AgitPOV/Coyote/circuit/coyote 1/stencil/AgitPOV_coyote_stencil.png

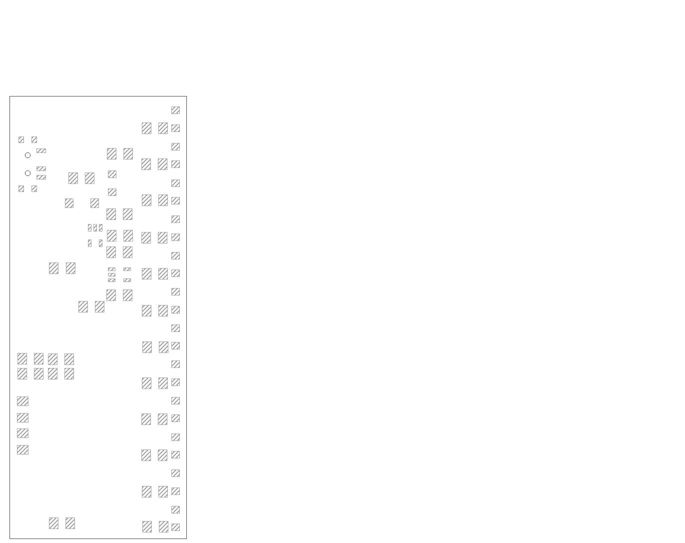
circuit/coyote 1/stencil/AgitPOV_coyote_stencil.png
