AgitPOV/Coyote/circuit/coyote 1/BOM/Coyote Partslist.ods

Item # | Qty | Numéro | Valor | Codigo | QTY | Prix Digikey Canada | http://www.sigmaelectronica.net | http://www.didacticaselectronicas.com | http://www.microelectronicos.com | Prix par POV / Digikey | Notas
 | 1 | C1 | 470 pF | 311-1167-1-ND | 100 | 0.0531 | - | - | - | 0.0531
 | 3 | C2,C3, C4 | .1 uF | 311-1179-1-ND | 100 | 0.0434 | 0.029 | 0.025 | 0.025 | 0.1302 | 100 nF = 0.1uF
 | 3 | C6, C7. C8 | 4.7 uF | 1276-1191-1-ND | 100 | 0.0793 |  | 0.025 | - | 0.2379
 | 2 | C5, C9 | 18 pF | 311-1152-1-ND | 100 | 0.0632 | - | 0.025 | - | 0.1264 | Selon le datasheet
 | 1 | Hall Sensor |  | 620-1330-ND | 100 | 1.0393 | - | - | - | 1.0393
 | 1 | MCP 73831 |  | MCP73831T-2ACI/OTCT-ND | 100 | 0.501 |  |  |  | 0.501
 | 1 | D1 | B340A | B340A-FDICT-ND | 100 | 0.3322 | - | 0.82 | - | 0.3322
 | 1 | MIC 5219 |  | 576-1281-1-ND | 100 | 1.6827 |  |  |  | 1.6827
 | 1 | Switch SPDT |  | 563-1102-1-ND | 100 | 0.6826 |  | 1.33 |  | 0.6826
 | 1 | Atmega |  | ATMEGA168A-PU-ND | 100 | 2.6232 | 3.86 | - | - | 2.6232
 | 1 | Piles LiPO | 3,7 V 450 ma |  | 100 | 3 |  |  |  | 3
 |  | JP2 |  |  |  |  |  |  |  | 0
 | 1 | LED 1 |  | vert normcore |  |  |  |  |  | 0
 | 1 | Connecteur USB - USB MB h |  | WM17121-ND | 100 | 2.1121 | - | - | - | 2.1121
 | 1 | Push button switch |  | SW400-ND | 100 | 0.3843 | - | 0.051 | - | 0.3843
 | 1 | R1 | 330 | RMCF1206JT330RCT-ND | 100 | 0.0178 |  |  |  | 0.0178
 | 2 | R2, R4 | 10k | RMCF1206JT10K0CT-ND | 100 | 0.0178 | 0.0123 |  |  | 0.0356
 | 12 | R 3, 5-15 | 51 | 311-51ERCT-ND | 100 | 0.0132 |  |  |  | 0.1584 | bonjour coco!
 | 1 | R18 | 1.5 k | 311-1.50KFRCT-ND | 100 | 0.0168 |  |  |  | 0.0168 | <3
 | 2 | R16, R17 | 68 ohms | 311-51ERCT-ND | 100 | 0.0267 | 0.0123 |  |  | 0.0534 | hola gatito!
 | 1 | Y2 Crystal | 12 Mhz | CTX904-ND | 100 | 0.2863 | - | - | - | 0.2863
 |  | LED Rojo |  | 754-1143-1-ND / 754-1113-1-ND |  |  |  |  |  | 0
 | 12 | LED Naranja |  | 754-1140-1-ND | 100 | 0.1358 |  |  |  | 1.6296
 |  |  |  |  |  |  |  |  |  | 0
 | 1 | Female Headers | 4 | S7037-ND | 100 | 0.4348 |  | 0.6664 |  | 0.4348 | cher!!
 | 1 | Female Headers | 5 | S7038-ND | 100 | 0.4563 |  | 0.6664 |  | 0.4563 | tambien!
 | 1 | Plaquetas |  | Coyote 1 |  | 2.5 |  | (Ultimate PCB) |  | 2.5
 | 1 | Stencil |  |  |  | 2 |  | (Stentech) |  | 2
 |  |  |  |  |  |  |  |  |  | 20.494
 | 1 | Caja |  |  |  | 4 |  |  |  | 4 | Avec l'aide de Danny
 |  |  |  |  |  |  |  |  |  |  | bravo Danny¡¡ :)
 | 1 | Portamicros |  |  |  |  | 0.1189 |  | 0.205
(option) | 2 | C5, C9 | 27 pF / thomas dice mejor 18pf | 445-1779-1-ND | 100 |  | - | 0.025 | - | 0 | Option, valeur du schéma
