AgitPOV/Coyote/circuit/coyote 1/stencil/AgitPOV_coyote_1.pdf

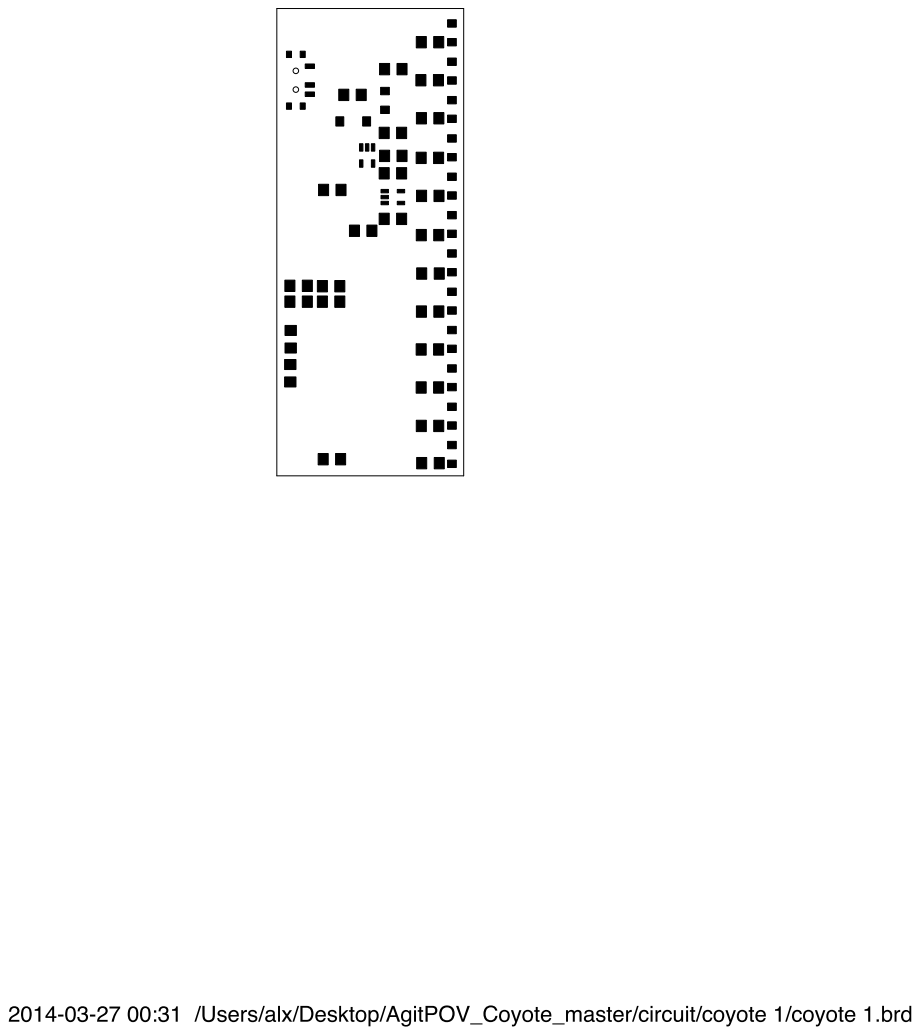
[picture p3: page 1]
