AgitPOV/Coyote/circuit/coyote 1/coyote 1.brd

## EAGLE design circuit/coyote 1/coyote 1.brd (2014-03-27)

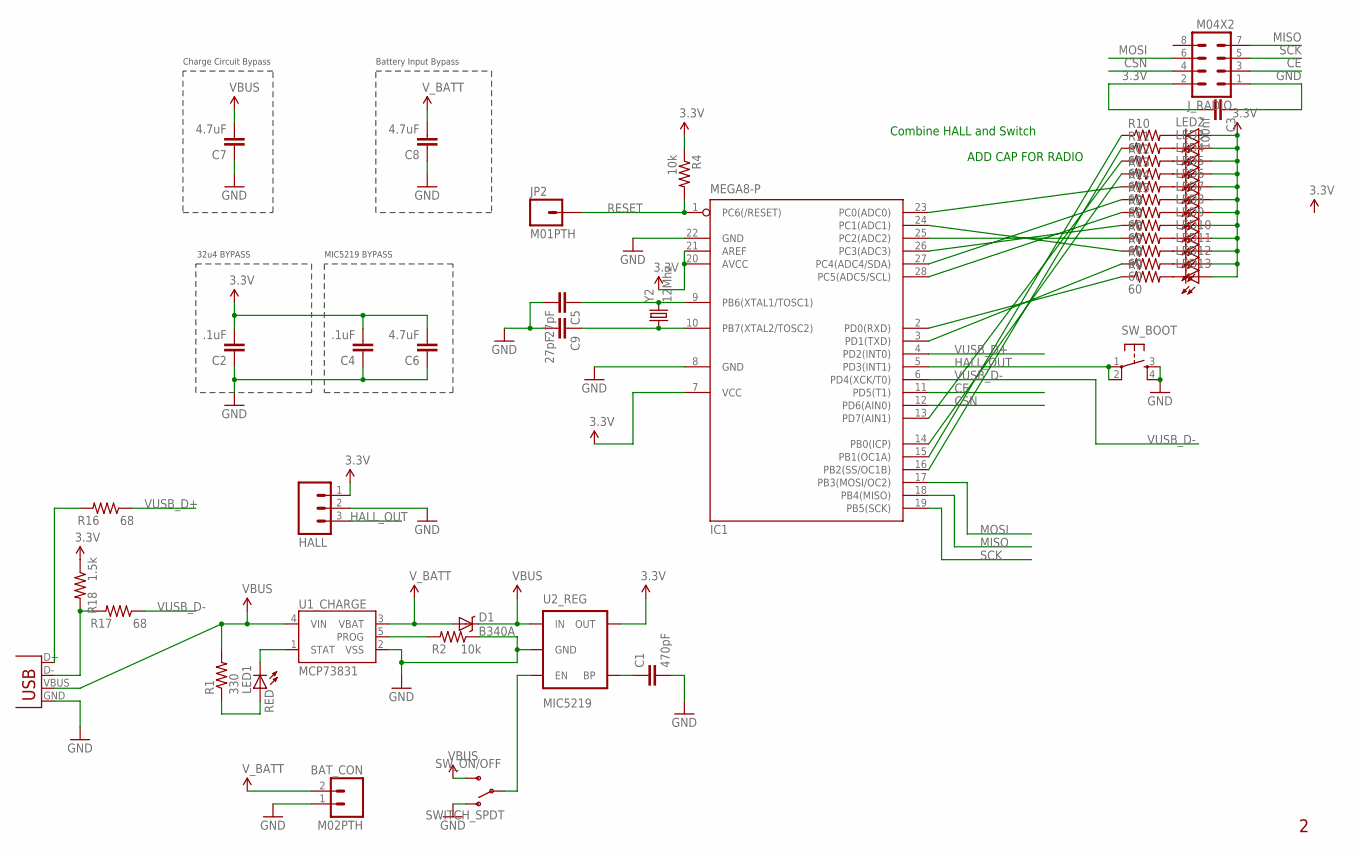
[picture p4: schematic coyote 1.sch]

Parts:
BAT_CON: M02PTH; 1X02
C1: 470pF; 1206
C2, C4: .1uF; 1206
C3: 100nf; 1206
C5, C9: 27pF; 1206
C6, C7, C8: 4.7uF; 1206
D1: B340A; SMA-DIODE
HALL: M03PTH; 1X03
IC1: MEGA8-P; DIL28-3
JP1: USB-MB-H
JP2: M01PTH; 1X01
J_RADIO: M04X2; 2X4
LED1: RED; LED-1206
LED2, LED3, LED4, LED5, LED6, LED7, LED8, LED9, LED10, LED11, LED12, LED13: LED1206; LED-1206
R1: 330; 1206
R2, R4: 10k; 1206
R3, R5, R6, R7, R8, R9, R10, R11, R12, R13, R14, R15: 60; 1206
R16, R17: 68; 1206
R18: 1.5k; 1206
SW_BOOT: TAC_SWITCHPTH; TACTILE-PTH
SW_ON/OFF: SWITCH_SPDT; KPS-1290
U1_CHARGE: MCP73831; SOT23-5
U2_REG: MIC5219; SOT23-5
Y2: 12Mhz; HC49US

Connections:
3.3V: C2.2, C3.2, C4.2, C6.2, HALL.1, IC1.7 (VCC), IC1.20 (AVCC), IC1.21 (AREF), J_RADIO.2, LED2.A, LED3.A, LED4.A, LED5.A, LED6.A, LED7.A, LED8.A, LED9.A, LED10.A, LED11.A, LED12.A, LED13.A, R4.1, R18.1, U2_REG.5 (OUT)
5V: C7.2, D1.C, JP1.VBUS, R1.2, SW_ON/OFF.S, U1_CHARGE.4 (VIN), U2_REG.1 (IN)
CE: IC1.11 (PD5(T1)), J_RADIO.3
CSN: IC1.12 (PD6(AIN0)), J_RADIO.4
D+: JP1.D+, R16.2
D-: JP1.D-, R17.2, R18.2
GND: BAT_CON.1, C1.2, C2.1, C3.1, C4.1, C5.2, C6.1, C7.1, C8.1, C9.2, HALL.2, IC1.8 (GND), IC1.22 (GND), JP1.GND, J_RADIO.1, R2.1, SW_BOOT.3, SW_BOOT.4, SW_ON/OFF.O, U1_CHARGE.2 (VSS), U2_REG.2 (GND)
HALL_OUT: HALL.3, IC1.5 (PD3(INT1)), SW_BOOT.1, SW_BOOT.2
MISO: IC1.18 (PB4(MISO)), J_RADIO.7
MOSI: IC1.17 (PB3(MOSI/OC2)), J_RADIO.6
unnamed: SW_ON/OFF.P, U2_REG.3 (EN)
unnamed: LED1.A, R1.1
unnamed: LED1.C, U1_CHARGE.1 (STAT)
unnamed: LED8.C, R3.2
unnamed: R2.2, U1_CHARGE.5 (PROG)
unnamed: LED9.C, R5.2
unnamed: C1.1, U2_REG.4 (BP)
unnamed: LED10.C, R6.2
unnamed: IC1.13 (PD7(AIN1)), R12.1
unnamed: LED11.C, R7.2
unnamed: LED12.C, R8.2
unnamed: LED13.C, R9.2
unnamed: LED2.C, R10.2
unnamed: LED3.C, R11.2
unnamed: LED4.C, R12.2
unnamed: LED5.C, R13.2
unnamed: LED6.C, R14.2
unnamed: LED7.C, R15.2
unnamed: IC1.15 (PB1(OC1A)), R10.1
unnamed: IC1.16 (PB2(SS/OC1B)), R11.1
unnamed: IC1.14 (PB0(ICP)), R13.1
unnamed: IC1.2 (PD0(RXD)), R9.1
unnamed: IC1.3 (PD1(TXD)), R8.1
unnamed: IC1.23 (PC0(ADC0)), R14.1
unnamed: IC1.27 (PC4(ADC4/SDA)), R15.1
unnamed: IC1.28 (PC5(ADC5/SCL)), R3.1
unnamed: IC1.24 (PC1(ADC1)), R7.1
unnamed: IC1.25 (PC2(ADC2)), R6.1
unnamed: IC1.26 (PC3(ADC3)), R5.1
unnamed: C5.1, IC1.9 (PB6(XTAL1/TOSC1)), Y2.2
unnamed: C9.1, IC1.10 (PB7(XTAL2/TOSC2)), Y2.1
RESET: IC1.1 (PC6(/RESET)), JP2.1, R4.2
SCK: IC1.19 (PB5(SCK)), J_RADIO.5
VUSB_D+: IC1.4 (PD2(INT0)), R16.1
VUSB_D-: IC1.6 (PD4(XCK/T0)), R17.1
V_BATT: BAT_CON.2, C8.2, D1.A, U1_CHARGE.3 (VBAT)

Notes on the sheet:
32u4 BYPASS
MIC5219 BYPASS
Charge Circuit Bypass
Battery Input Bypass
ADD CAP FOR RADIO
Combine HALL and Switch

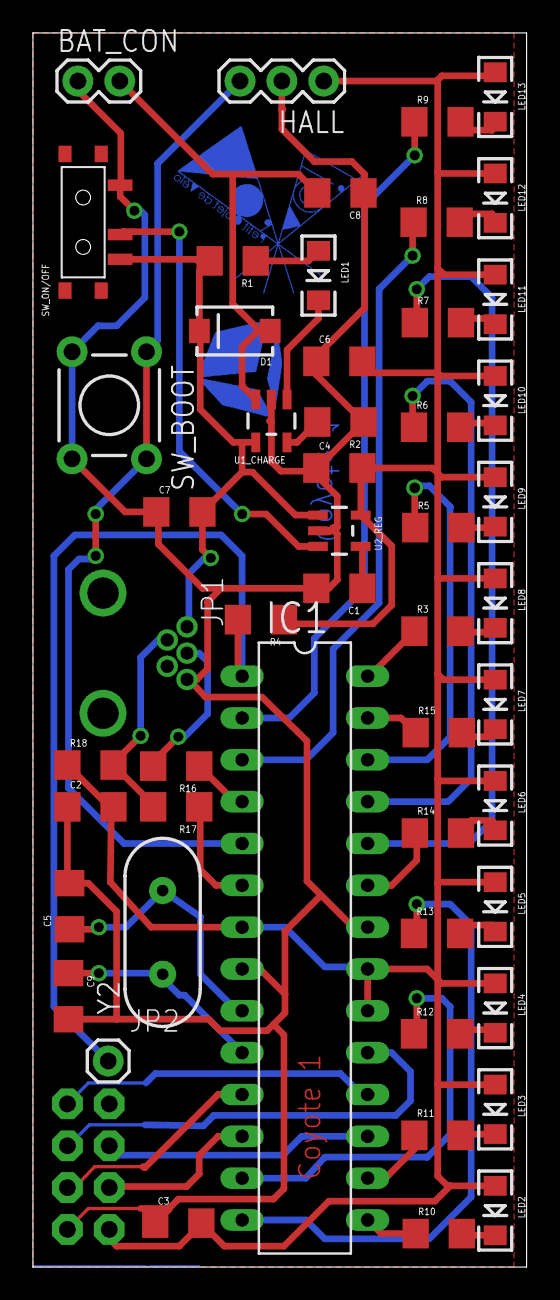
[picture p5: board coyote 1.brd from above]

Board: 2 copper layers, 30.0 x 74.9 mm, 52 parts (1 on the bottom side), 46 nets.
