AgitPOV/Coyote/(commit log)

2013-12-24 A little clean-up
    [coyote 1.brd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]
2014-03-27 Added gerber files and added logos
    [coyote 1.brd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]
2014-04-08 The parts list
    Values and digikey # of parts (+ prices as of 08/04/2014) for the
    Coyote 1 .
    [Coyote Partslist.ods]
2014-04-12 Parts layout
    la carte de l'orientation et des valeurs des pièces par Mariangela.
2014-04-20 Stamp function in pixmap (sub-pixmap insert).
2014-04-20 Bug fix in Pixmap(PImage) constructor: was using bad values
    [Pixmap.pde]
2014-04-20 Reworked with memory string (not tested for RTL).
    [TextTool.pde]
2014-04-21 Prevent erase when cursor at beginning
    [TextTool.pde]
2014-04-21 Allow insert of key at cursor point
2014-04-21 Bug fix in the computation of the row number according to absolute index.
    [Pixmap.pde]
2014-04-21 Bug fix for RTL (cursor was misplaced)
    [TextTool.pde]
2014-04-21 Export buttons
2014-04-21 Cosmetic change in button LTR/RTL
2014-04-21 Added erase and invert functions and cleaned up
    [Pixmap.pde]
2014-04-23 Bugfix for graphics when text has 0 width
    [TextTool.pde]
2014-04-30 Added some define hacks for wheel radius adjustments (needs work/refinement)
2014-05-15 Added possibility for hexa based fonts + added font from Alex Keeling
    [font_alex_keeling.csv]
2014-05-19 Updating the radio code
    [font_alex_keeling.csv]
2014-05-29 Added a wheel display
2014-05-29 Added hardware definitions
    [font_alex_keeling.csv]
2014-06-01 Squashed the wheel display
